ZhunHao/nfc-card/hardware/terminal/LAYOUT.md

# B3 Terminal LED placement (generated by build_terminal.py)

Chain position P0-P8 are the line-status LEDs top to bottom; P9-P19 the bar right to left.
LED index k is D[k+1]: anode CP[k/4], cathode as in the NTUAS mapping.

| Position | Role | Ref | Index k | Anode | Cathode | KiCad x, y (mm) |
| --- | --- | --- | --- | --- | --- | --- |
| P0 | line 1 | D1 | 0 | CP0 | CP1 | 175.00, 112.90 |
| P1 | line 2 | D5 | 4 | CP1 | CP0 | 175.00, 115.15 |
| P2 | line 3 | D10 | 9 | CP2 | CP1 | 175.00, 117.40 |
| P3 | line 4 | D2 | 1 | CP0 | CP2 | 175.00, 119.65 |
| P4 | line 5 | D9 | 8 | CP2 | CP0 | 175.00, 121.90 |
| P5 | line 6 | D6 | 5 | CP1 | CP2 | 175.00, 124.15 |
| P6 | line 7 | D14 | 13 | CP3 | CP1 | 175.00, 126.40 |
| P7 | line 8 | D3 | 2 | CP0 | CP3 | 175.00, 128.65 |
| P8 | line 9 | D13 | 12 | CP3 | CP0 | 175.00, 130.90 |
| P9 | bar 11 | D7 | 6 | CP1 | CP3 | 175.00, 144.60 |
| P10 | bar 10 | D18 | 17 | CP4 | CP1 | 171.80, 144.60 |
| P11 | bar 9 | D4 | 3 | CP0 | CP4 | 168.60, 144.60 |
| P12 | bar 8 | D17 | 16 | CP4 | CP0 | 165.40, 144.60 |
| P13 | bar 7 | D12 | 11 | CP2 | CP4 | 162.20, 144.60 |
| P14 | bar 6 | D15 | 14 | CP3 | CP2 | 159.00, 144.60 |
| P15 | bar 5 | D11 | 10 | CP2 | CP3 | 155.80, 144.60 |
| P16 | bar 4 | D19 | 18 | CP4 | CP2 | 152.60, 144.60 |
| P17 | bar 3 | D16 | 15 | CP3 | CP4 | 149.40, 144.60 |
| P18 | bar 2 | D20 | 19 | CP4 | CP3 | 146.20, 144.60 |
| P19 | bar 1 | D8 | 7 | CP1 | CP4 | 143.00, 144.60 |
