ZhunHao/nfc-card/hardware/orbit/orbit.kicad_pcb

## KiCad design hardware/orbit/orbit.kicad_pcb (2026-11-13)

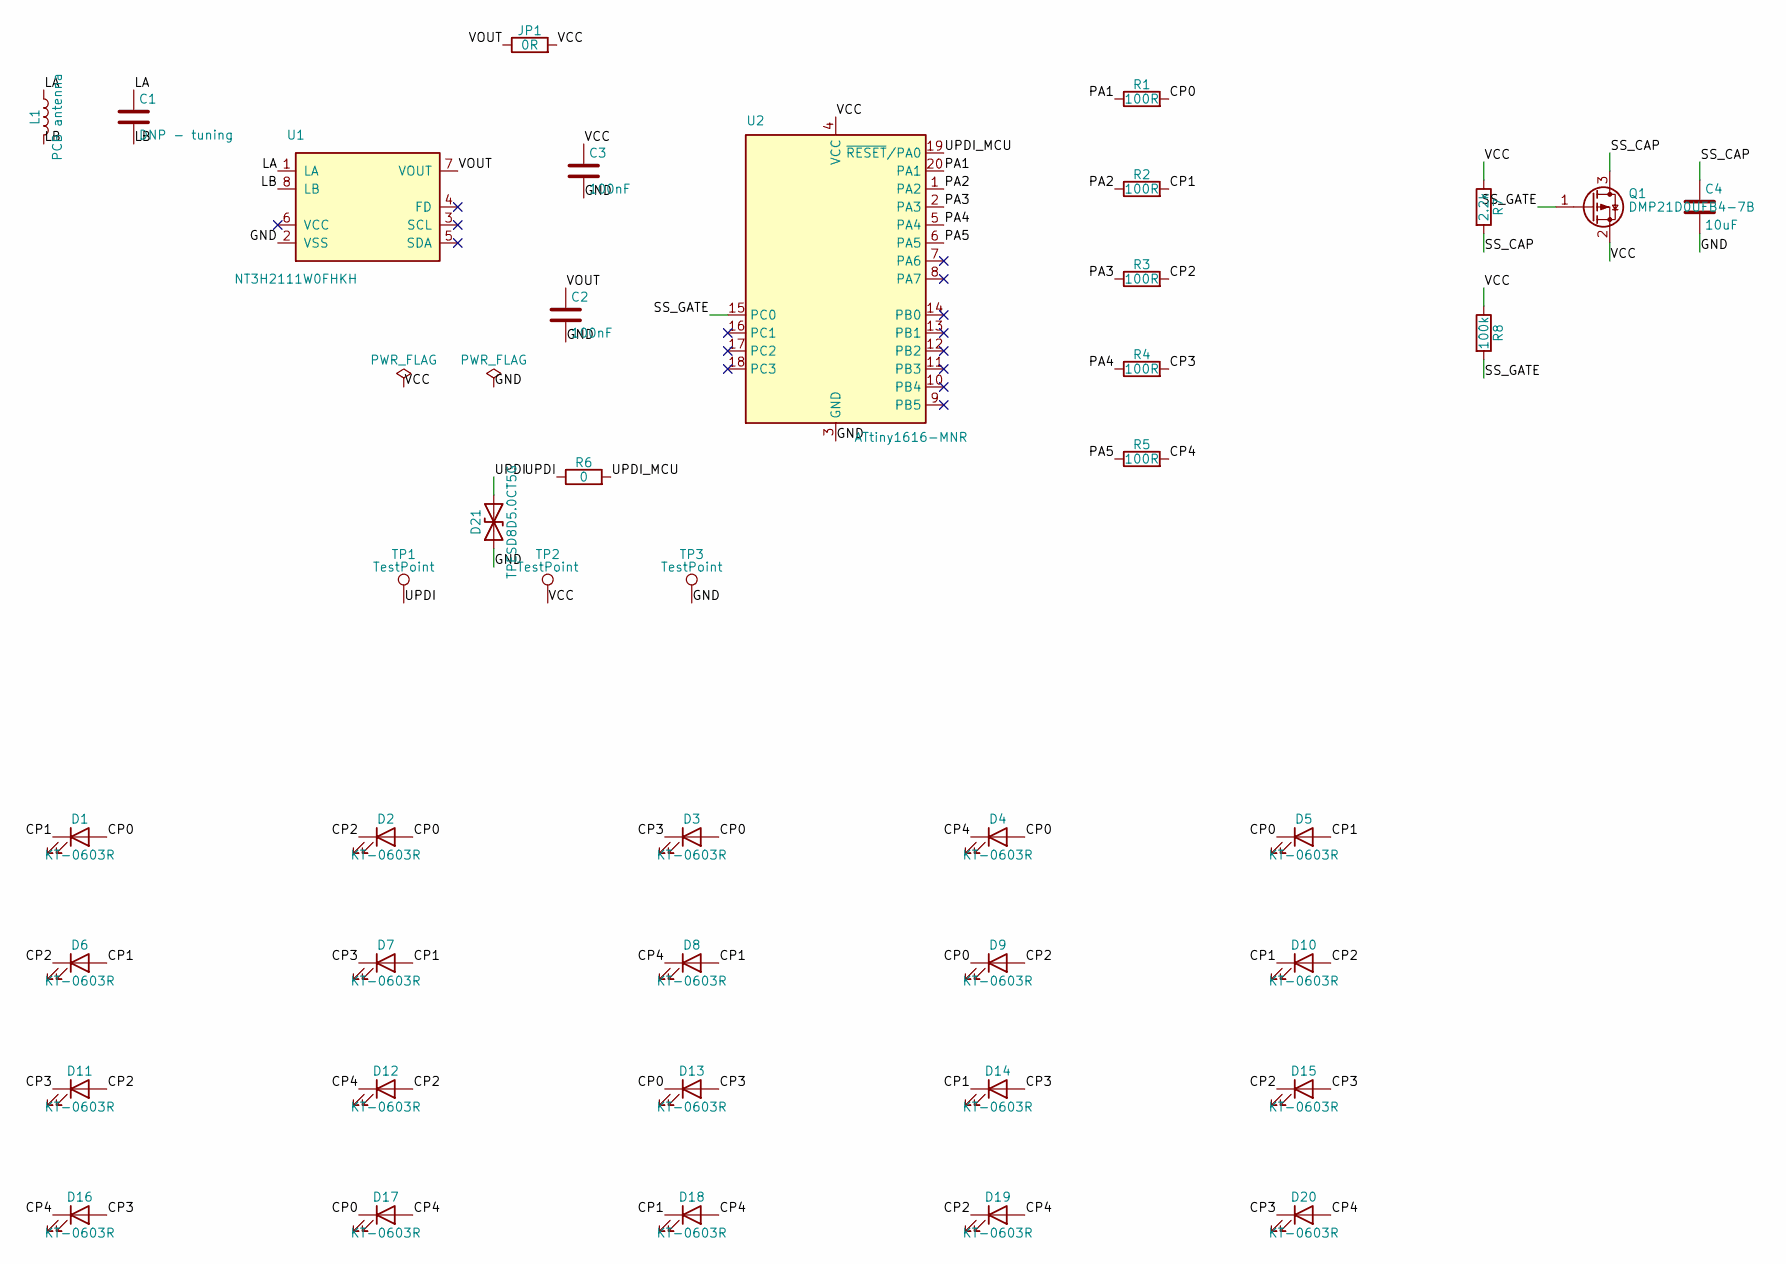
[picture p9: schematic orbit.kicad_sch]

Parts:
C1: DNP - tuning; C_0402_1005Metric
C2, C3: 100nF; C_0402_1005Metric; LCSC C1525
C4: 10uF; C_0402_1005Metric; LCSC C15525
D1, D2, D3, D4, D5, D6, D7, D8, D9, D10, D11, D12, D13, D14, D15, D16, D17, D18, D19, D20: KT-0603R; LED_0603_1608Metric; LCSC C2286
D21: TPESD8D5.0CT5G; D_SOD-882; LCSC C2827720
JP1: 0R; R_0603_1608Metric; LCSC C21189
L1: PCB antenna; NFC_Antenna_Rect_ID1_4turn_W090
Q1: DMP21D0UFB4-7B; Diodes_DFN1006-3; LCSC C155329
R1, R2, R3, R4, R5: 100R; R_0402_1005Metric; LCSC C25076
R6: 0; R_0402_1005Metric; LCSC C17168
R7: 2.2k; R_0402_1005Metric; LCSC C25879
R8: 100k; R_0402_1005Metric; LCSC C25741
TP1, TP2, TP3: TestPoint; TestPoint_Pad_D1.5mm
U1: NT3H2111W0FHKH; XQFN-8_1.6x1.6mm_P0.5mm_NXP_SOT902-3; LCSC C710403
U2: ATtiny1616-MNR; QFN-20-1EP_3x3mm_P0.4mm_EP1.65x1.65mm; LCSC C507118

Connections:
/CP0: D1.2 (A), D2.2 (A), D3.2 (A), D4.2 (A), D5.1 (K), D9.1 (K), D13.1 (K), D17.1 (K), R1.2
/CP1: D1.1 (K), D5.2 (A), D6.2 (A), D7.2 (A), D8.2 (A), D10.1 (K), D14.1 (K), D18.1 (K), R2.2
/CP2: D2.1 (K), D6.1 (K), D9.2 (A), D10.2 (A), D11.2 (A), D12.2 (A), D15.1 (K), D19.1 (K), R3.2
/CP3: D3.1 (K), D7.1 (K), D11.1 (K), D13.2 (A), D14.2 (A), D15.2 (A), D16.2 (A), D20.1 (K), R4.2
/CP4: D4.1 (K), D8.1 (K), D12.1 (K), D16.1 (K), D17.2 (A), D18.2 (A), D19.2 (A), D20.2 (A), R5.2
/GND: C2.2, C3.2, C4.2, D21.1 (A1), TP3.1 (1_1), U1.2 (VSS), U2.3 (GND), U2.21 (GND)
/LA: C1.1, L1.1, U1.1 (LA)
/LB: C1.2, L1.2, U1.8 (LB)
/PA1: R1.1, U2.20 (PA1)
/PA2: R2.1, U2.1 (PA2)
/PA3: R3.1, U2.2 (PA3)
/PA4: R4.1, U2.5 (PA4)
/PA5: R5.1, U2.6 (PA5)
/SS_CAP: C4.1, Q1.3 (D), R7.2
/SS_GATE: Q1.1 (G), R8.2, U2.15 (PC0)
/UPDI: D21.2 (A2), R6.1, TP1.1 (1_1)
/UPDI_MCU: R6.2, U2.19 (~RESET/PA0)
/VCC: C3.1, JP1.2, Q1.2 (S), R7.1, R8.1, TP2.1 (1_1), U2.4 (VCC)
/VOUT: C2.1, JP1.1, U1.7 (VOUT)

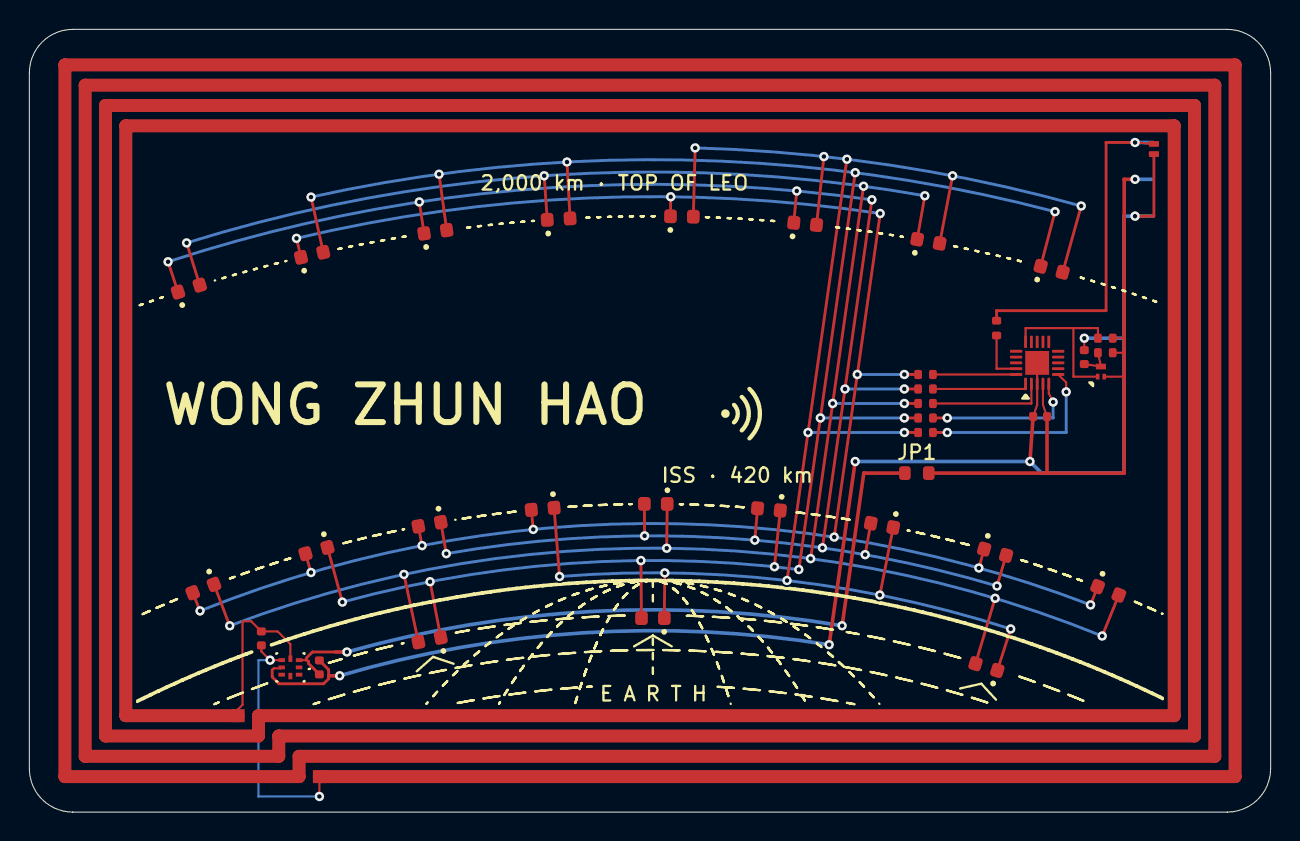
[picture p10: board orbit.kicad_pcb from above]

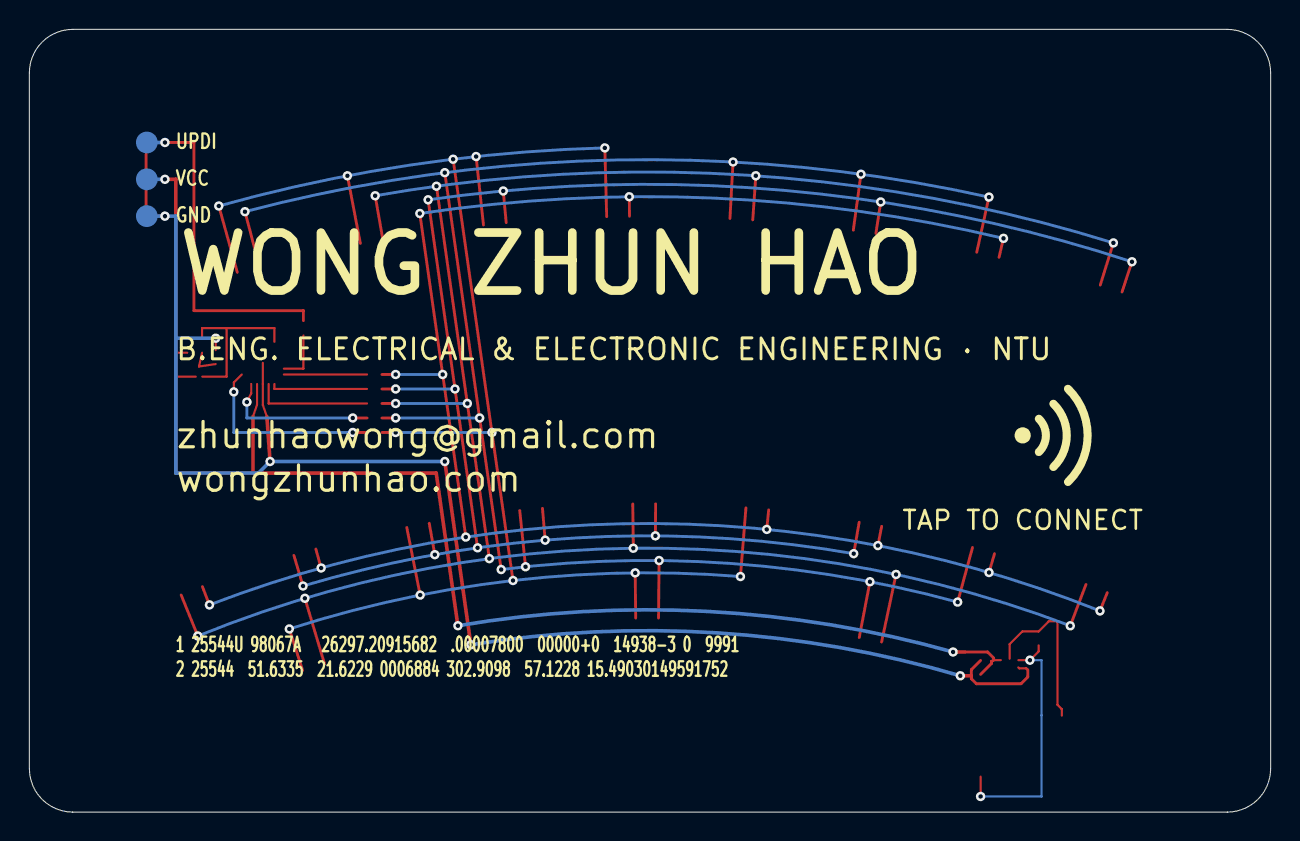
[picture p11: board orbit.kicad_pcb from below]

Board: 2 copper layers, 85.6 x 54.0 mm, 41 parts (3 on the bottom side), 19 nets.
